CircuitCo/BeagleBone-LCD3-RevA2/BeagleBone-LCD3-RevA2-bom.xls

BeagleBone LCD3 Cape COVER PAGE Revised: Tuesday, September 04, 2012
BB-BONE-LCD3-01 Revision: A2
ITM | QTY | REF DESIGNATOR | PART | FOOTPRINT | DESCRIPTION | MAN | PART # | COMMENT
1 | 3 | C1,C2,C13 | 10uF,10V | 805 | CAP CER 10UF 10V Y5V 0805 |  | C2012Y5V1A106Z
2 | 10 | C5,C6,C7,C8,C9,C10,C11,C12,C23,C41 | 0.1uF | 402 | Capacitor 0.1uF 16V 10% 0402 X7R |  | C0402C104K4RACT
3 | 2 | C38,C40 | 4.7uF, 25V | c805-35x60 | CAP CER 4.7UF 50V X5R 10% 0805 |  | C2012X5R1H475K
4 | 0 | C39 | 47nF, DNI | c402-25 | CAP CER 0.047UF 25V X5R 0402 |  | TMK105B7473KV-F
5 | 2 | D3,D5 | LTST-C190GKT | led2-31sq | LED GREEN CLEAR 0603 SMD |  | LTST-C190GKT
6 | 0 | D4 | MBRX140-TP, DNI | SOD-123 | DIODE SCHOTTKY 40V 1A SOD123 |  | MBRX140-TP
7 | 1 | FB8 | MMZ1608R301A | IND603-24X32 | FERRITE CHIP 300 OHM 500MA 0603 | TDK | MMZ1608R301A
8 | 1 | J1 | CONN PCB 10x2-S | HDR2x10 |  | MLE | BSTS-110-D-A-16-T-300-LF
9 | 1 | J2 | MALE HEADER 2x23 | HDR2x23 |  | MLE | BSTS-123-D-A-16-T-300-LF
10 | 0 | J3 | HEADER 3X2, DNI | HDR2x3 |  | MLE | BSTS-103-D-A-16-T-300-LF
11 | 1 | J4 | 62684-5521N0ALF | CONN55_P5MM_5X33SMD | CONN FPC/FFC 55POS .5MM R/A SMD |  | 62684-5521N0ALF
12 | 1 | L2 | 4.7uH | ind-lqh32m | INDUCTOR 4.7UH 20% 450MA 1210 |  | LQH32CN4R7M23L
13 | 0 | L3 | 18uH, DNI | IND390SMD_472SQ | INDUCTOR POWER 18UH 3.2A SMD | Wruth | 7447715180
14 | 0 | L4 | 10uH, DNI |  | INDUCTOR POWER 10UH 2.5A SMD | TDK | VLC6045T-100M
15 | 1 | Q1 | DMC56404 | SMini6-F3-B | TRANS PREBIASED DUAL NPN SOT363 |  | DDC114YU-7-F
16 | 1 | Q3 | BSS138 | SOT23-3 | MOSFET Nchan 50V 200mA | Diodes Inc. | BSS138-7-F
17 | 20 | R1,R4,R7,R8,R10,R12,R13,R14,R15,R19,R21,R23,R25,R27,R29,R31,R33,R35,R37,R39 | 33402 | 402 | RES 33.0 OHM 1/16W 1% 0402 SMD | Yaego | RC0402FR-0733RL
18 | 21 | R2,R3,R5,R6,R9,R11,R16,R17,R18,R20,R22,R24,R26,R28,R30,R32,R34,R36,R38,R40,R120 | 10402 | 402 | RES 10.0 OHM 1/16W 1% 0402 SMD | Yaego | RC0402FR-0710RL
19 | 2 | R63,R119 | 470 | r402-25 | Resistor 470ohm 1/16W 5% 0402 |  | ERJ-2GEJ471X
20 | 2 | R65,R66 | 5.6K,5% | 402 | RES 5.6K OHM 1/16W 5% 0402 SMD | Yaego | RC0402JR-075K6L
21 | 4 | R67,R68,R69,R72 | 4.75K | 402 | RES 4.75K OHM 1/16W 1% 0402 SMD | Stackpole Electronics | RMCF0402FT4K75
22 | 0 | R70,R71,R129 | 100K, DNI | r402-25
23 | 0 | R74,R76,R78,R84,R86,R87,R88,R123,R125,R128 | 0,DNI | c402-25
24 | 7 | R75,R77,R79,R85,R90,,R126,R127 | 0 | c402-25 | RES 0.0 OHM 1/16W 0402 SMD |  | RMCF0402ZT0R00
25 | 6 | R80,R81,R82,R83,R89,R139 | 10K | SM-7351-RES-0402 | Resistor 10Kohm 1/16W 5% 0402 | Rohm | MCR01MZPJ103
26 | 2 | R121,R122 | 100K,1% | 402 | RES 100K OHM 1/16W 5% 0402 SMD |  | RMCF0402JT100K
27 | 1 | R124 | 6.8K | c402-25 | RES 6.8K OHM 1/16W 1% 0402 SMD |  | ERJ-2RKF6801X
28 | 1 | R130 | 2R | 603 | RES 2.00 OHM 1/10W 1% 0603 SMD | Yaego | RC0603FR-072RL
29 | 0 | R131,R132,R134 | 0, DNI | 603
30 | 3 | R133,R135,R136 | 0 | 603 | RES 0.0 OHM 1/10W 0603 SMD | Yaego | RC0603JR-070RL
31 | 1 | SW1 | SW DIP-2 | swdip4_100-339smd | SWITCH TAPE SEAL 2 POS SMD | CTS | 219-2MST
32 | 1 | S1 | B3U-1100 | SW3_4X2P5 | SWITCH TACTILE SPST-NO 0.05A 12V |  | B3U-1100P
33 | 1 | S6 | B3F-3100 | SWRST4_177X256LS-1 | SWITCH TACTILE SPST-NO 0.05A 24V, RA | Omron | B3F-3100
34 | 5 | S2,S3,S4,S5,S7 | B3F-1000 | sw4-b3f-315x | SWITCH TACTILE SPST-NO 0.05A 24V | Omron | B3F-1000
35 | 0 | TP1,TP2 | T POINT A
36 | 1 | U1 | 74avc32t245 | BGA96-ZKE | IC BUS TRANSCVR 32BIT 96BGA | TI | SN74AVC32T245ZKER
37 | 1 | U4 | CAT24C256W | SOIC_8 | IC EEPROM 256KBIT 400KHZ 8SOIC | ON | CAT24C256WI-G
38 | 1 | U5 | TPS61080DRC | drc10-11x33 | IC REG LDO CAP FREE 8-SON | TI | TPS61080DRC
39 | 1 | U6 | SN74LVC1G06DCK | DCK5 |  | TI | SN74LVC1G06DCK
40 | 1 | PCB | BB-BONE-LCD3-PCB-03
41 | 1 | LCD |  |  | 3.5" TOUCHSREEN TFT LCD | Elpa | TO112T
