CircuitCo/BeagleBone-LCD3-RevA2/BeagleBone-LCD3-RevA2-schematic.pdf

10-March-2012 | BBT

# DATE

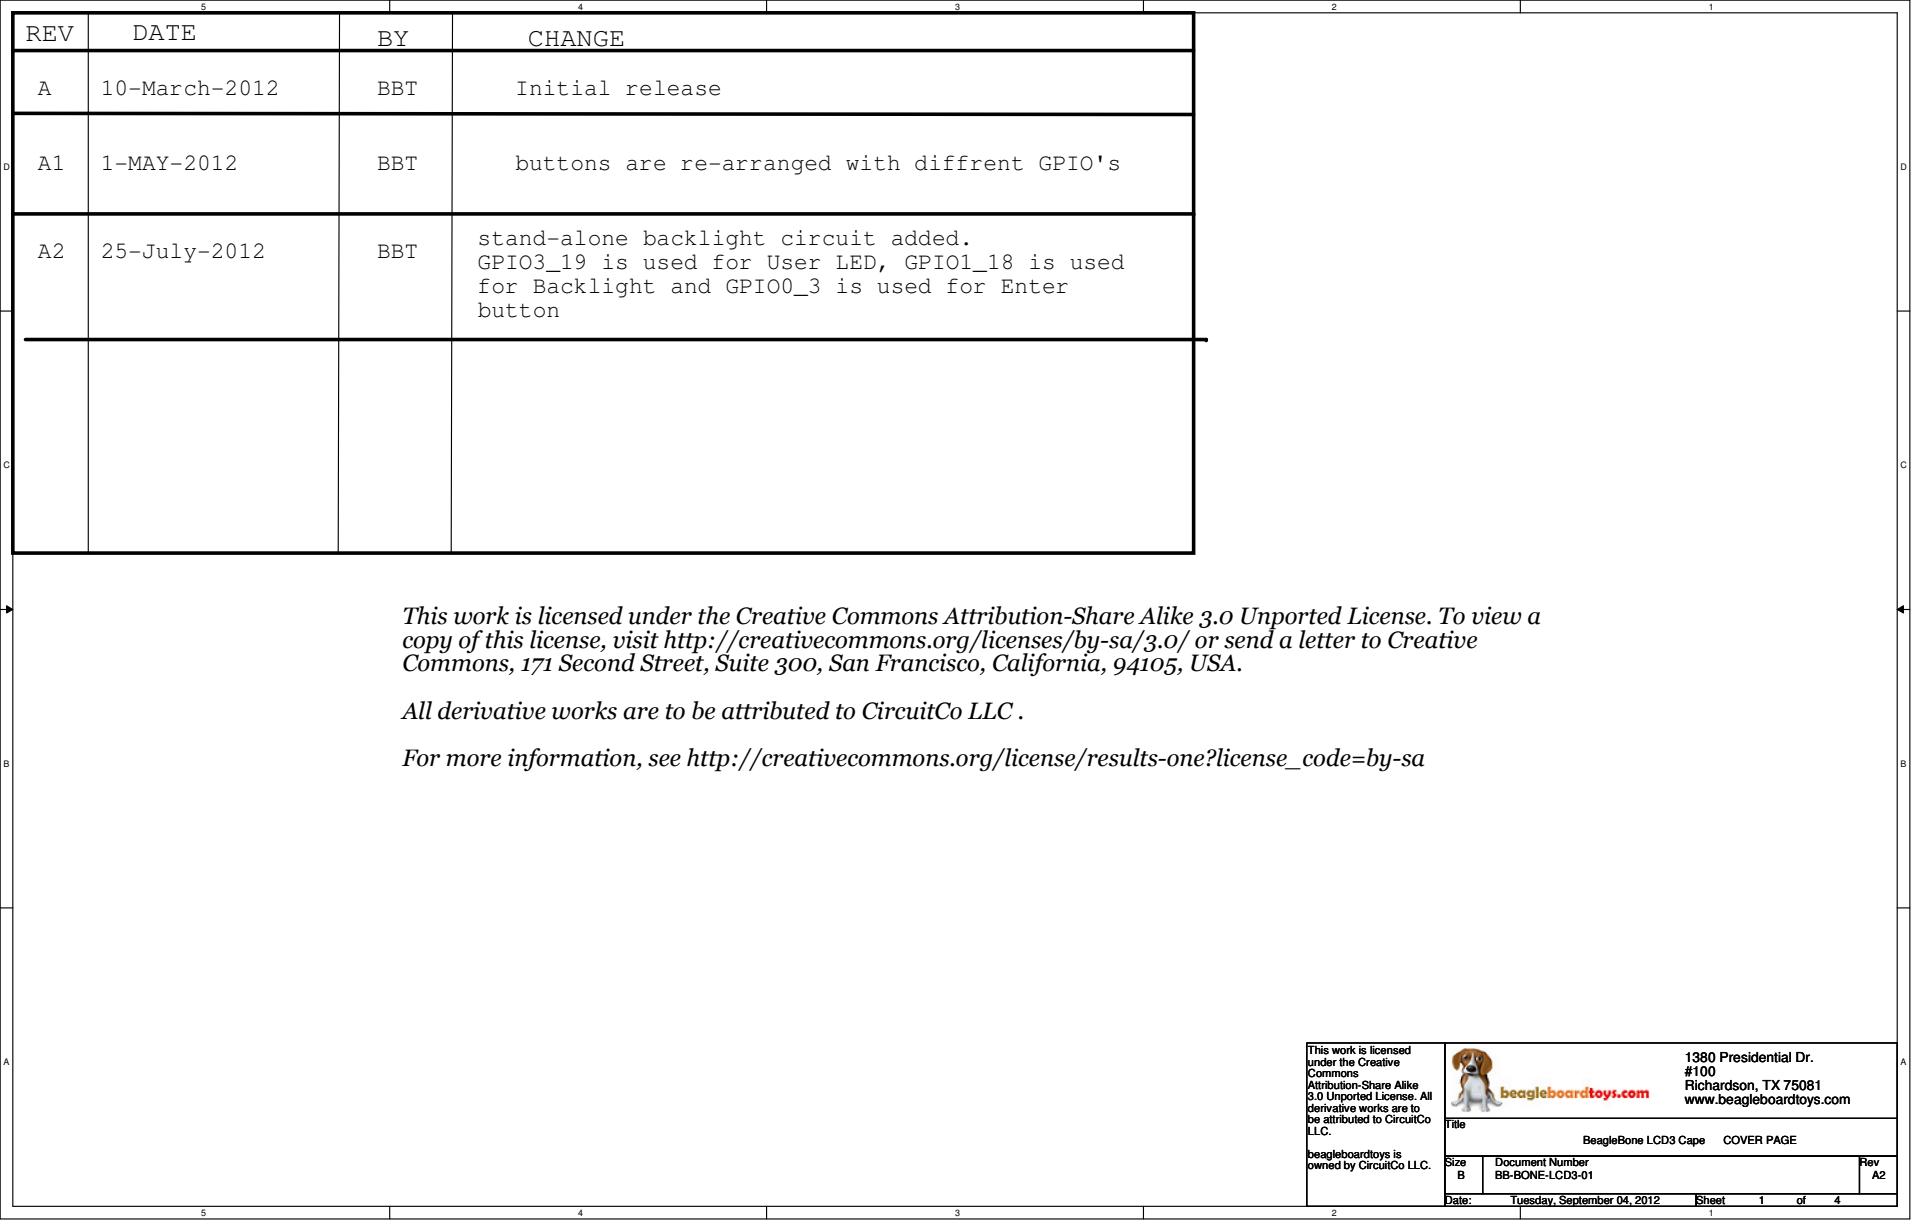
[picture p1: page 1]
REV; CHANGE; Initial release; 1-MAY-2012; BBT; buttons are re-arranged with diffrent GPIO's; 25-July-2012; stand-alone backlight circuit added. GPIO3_19 is used for User LED, GPIO1_18 is used; Title; Size; Document Number; Rev; Date:; Sheet; BB-BONE-LCD3-01; BeagleBone LCD3 Cape; COVER PAGE; Tuesday, September 04, 2012

for Backlight and GPIO0_3 is used for Enter
button

This work is licensed under the Creative Commons Attribution-Share Alike 3.0 Unported License. To view a
copy of this license, visit http://creativecommons.org/licenses/by-sa/3.0/ or send a letter to Creative
Commons, 171 Second Street, Suite 300, San Francisco, California, 94105, USA.

All derivative works are to be attributed to CircuitCo LLC .

For more information, see http://creativecommons.org/license/results-one?license_code=by-sa

This work is licensed
under the Creative
Commons
Attribution-Share Alike
3.0 Unported License. All
derivative works are to
be attributed to CircuitCo
LLC.

1380 Presidential Dr.
Richardson, TX 75081
www.beagleboardtoys.com

beagleboardtoys is
owned by CircuitCo LLC.

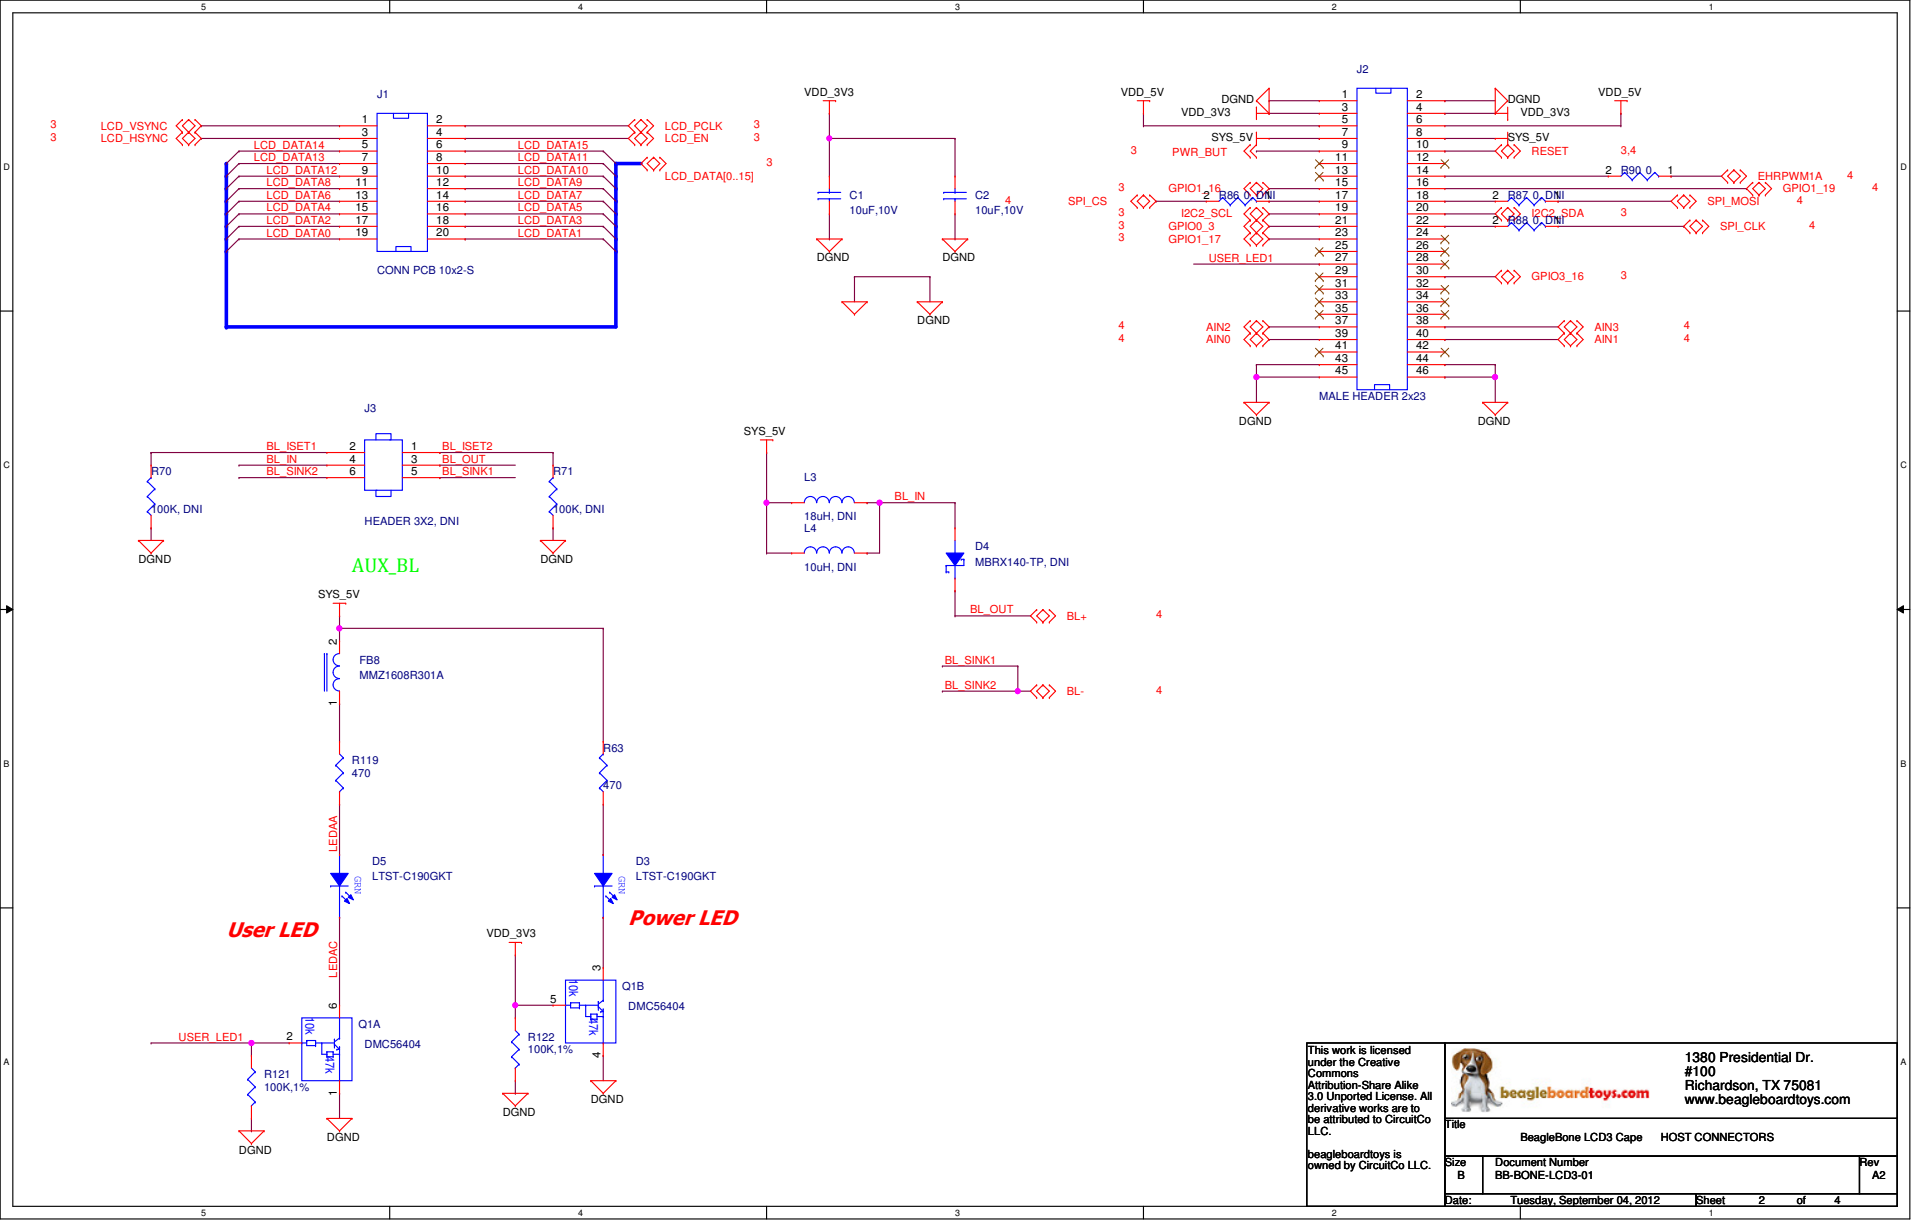
[picture p2: page 2]
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

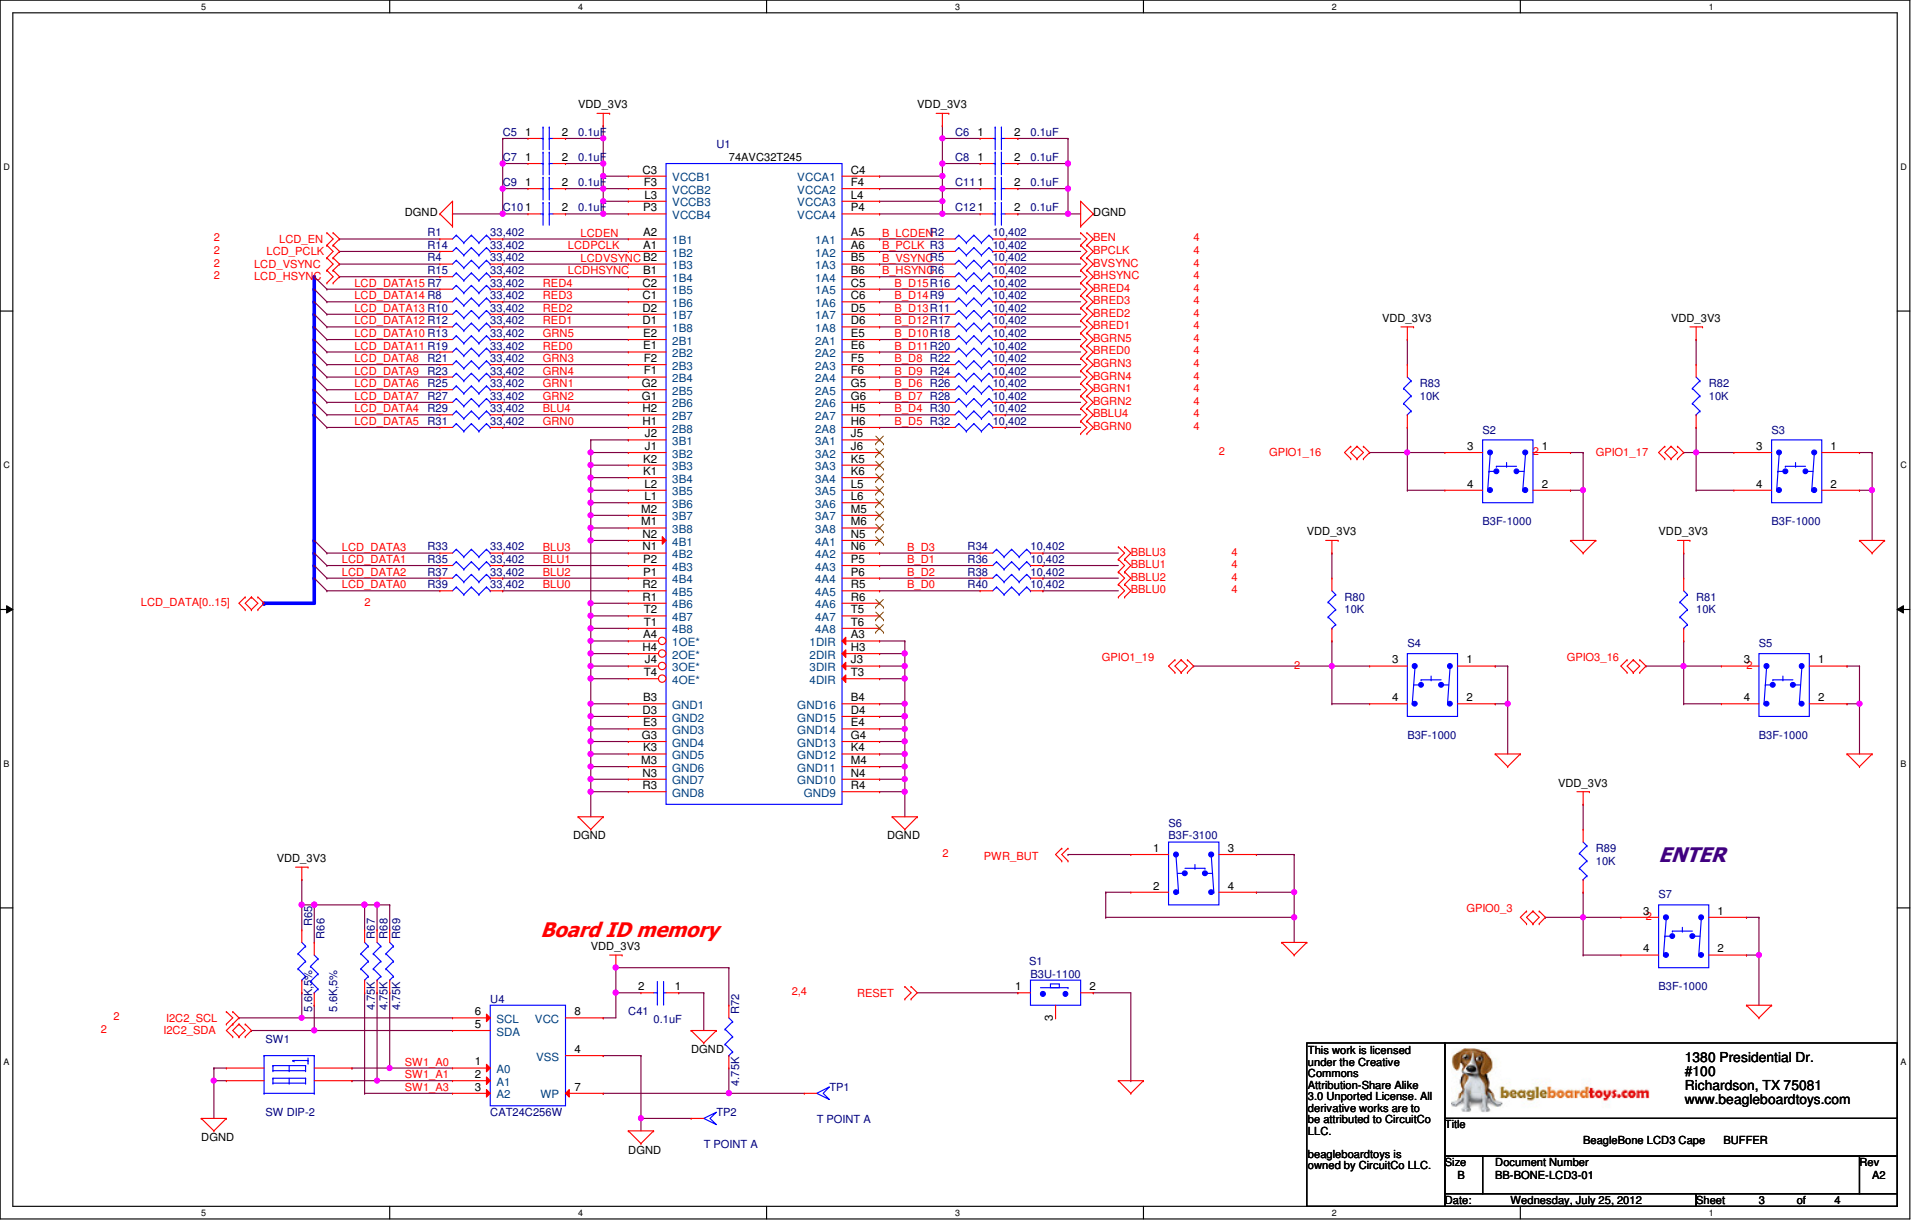
[picture p3: page 3]

C9 | 2 0.1uF 1
C10 | 2 0.1uF 1 | VCCB3 L3

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

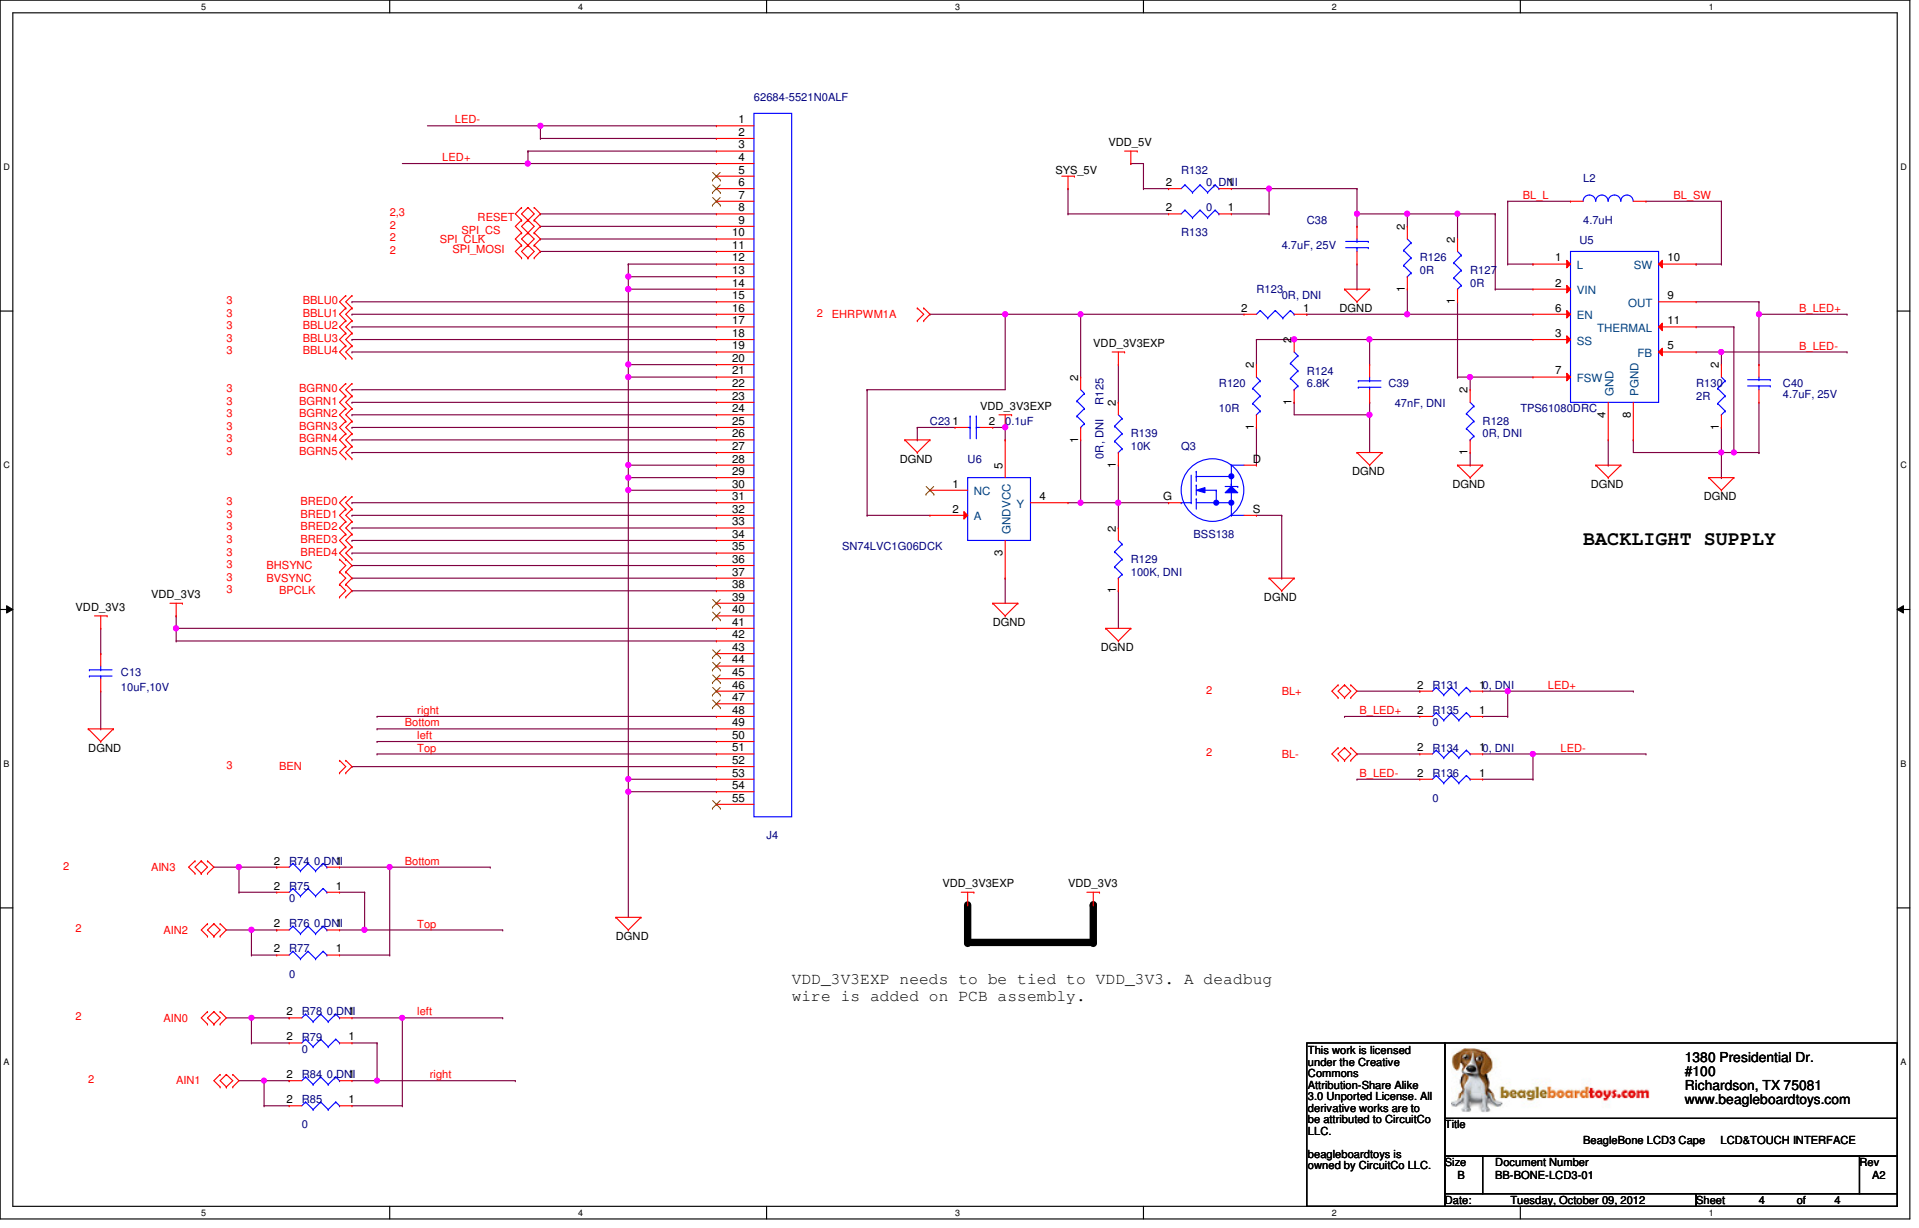
[picture p4: page 4]

VDD_3V3EXP needs to be tied to VDD_3V3. A deadbug
wire is added on PCB assembly.

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
