CircuitCo/BeagleBone-LCD3-RevA2/(list of files, drawings)

Other design files:
BeagleBone-LCD3-RevA2-schematic.dsn
